caltech-fsae/IOBoard2021/IOBoard2020.pdf

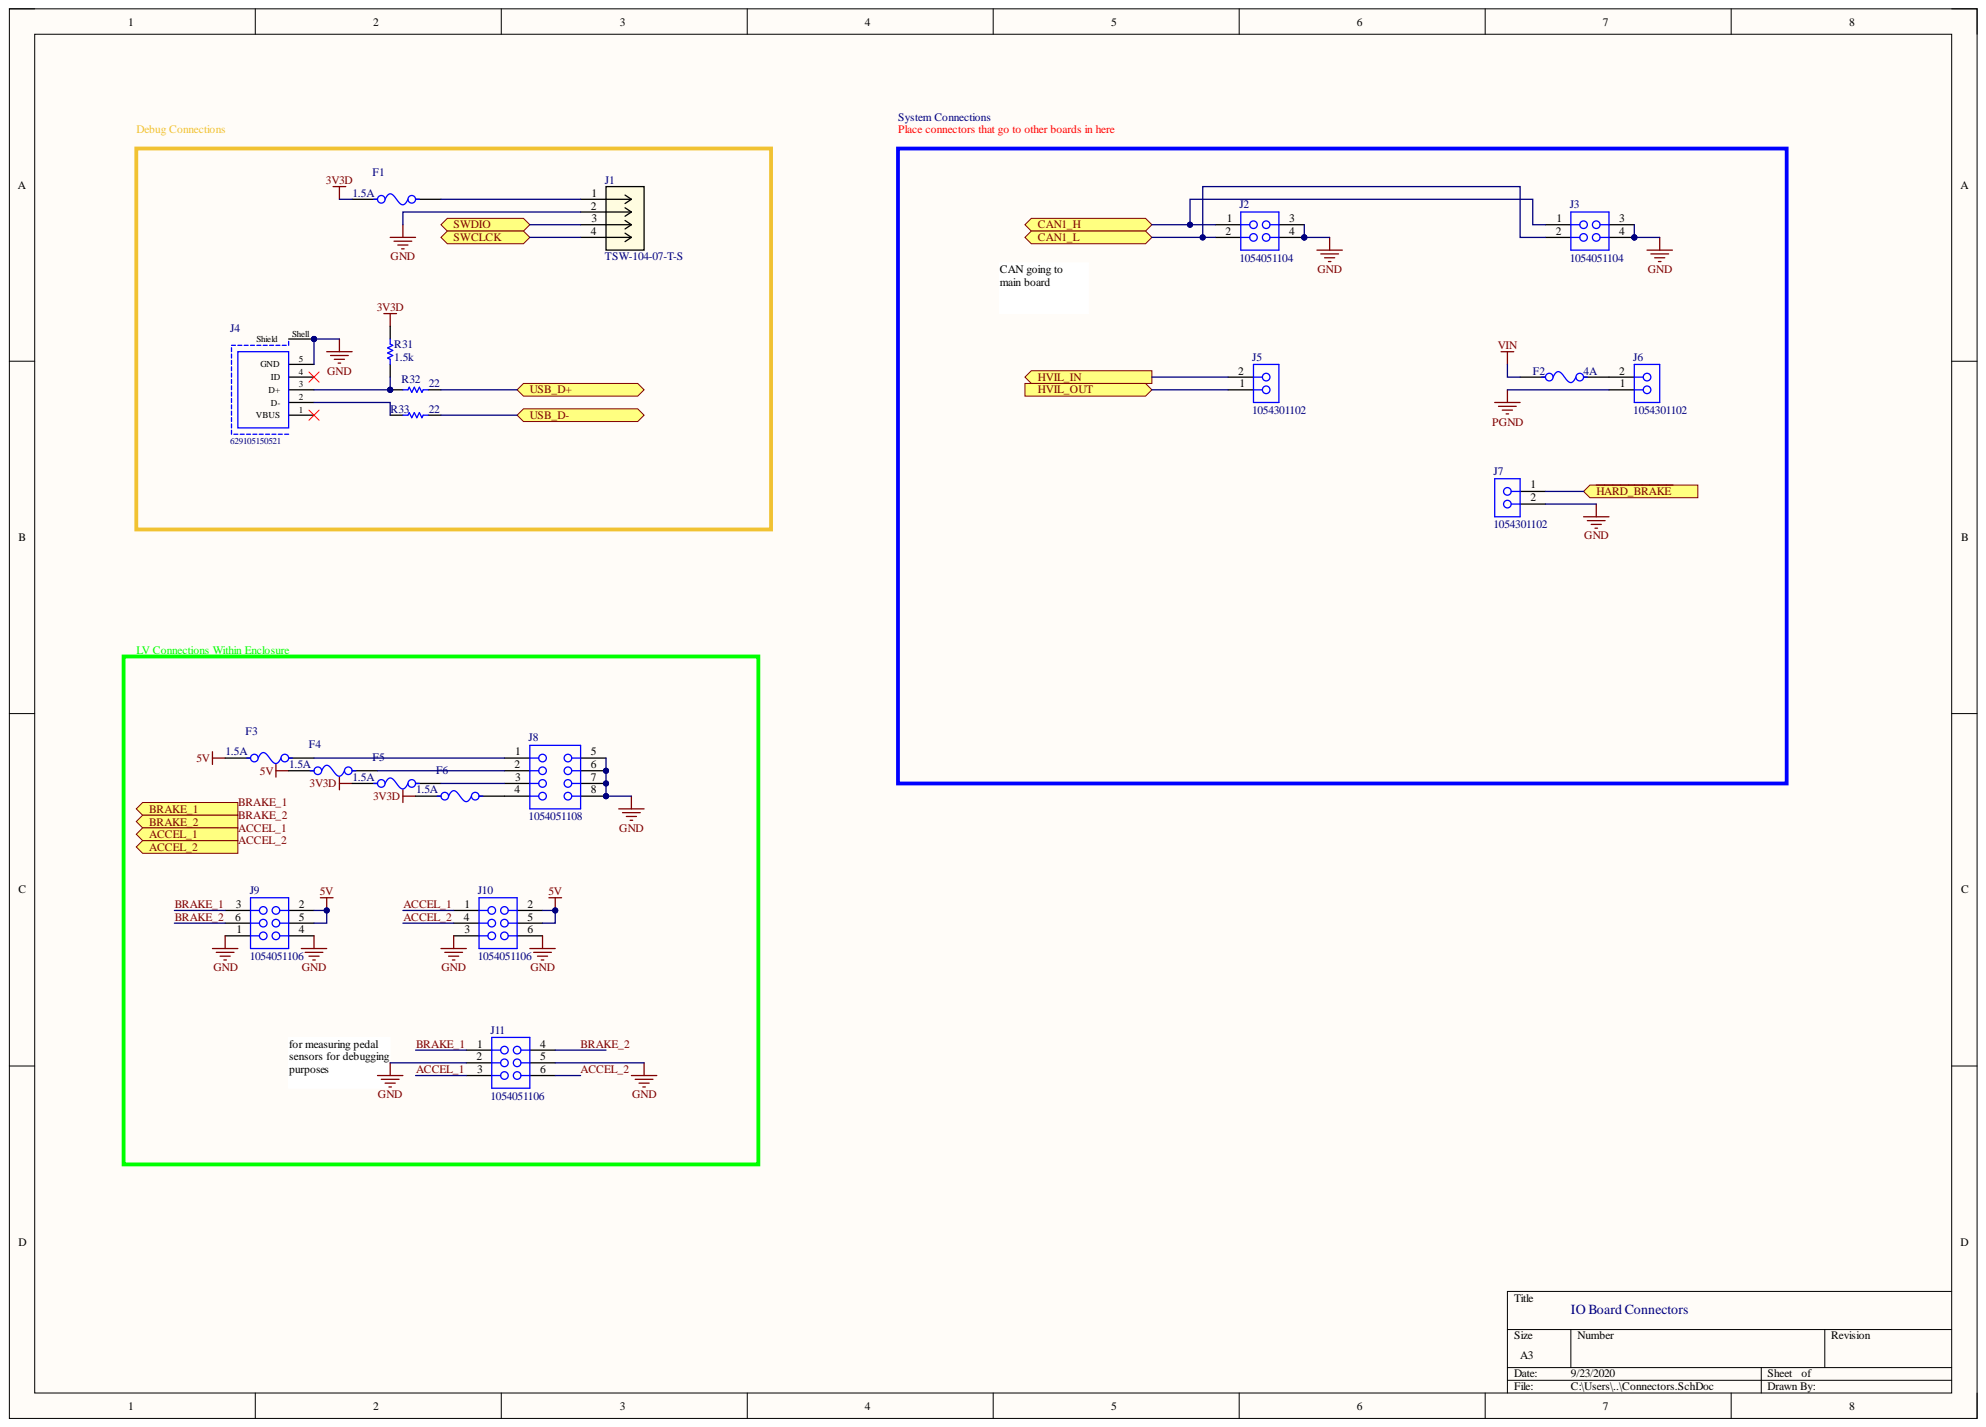
[picture p1: page 1]

J2 VIN

LV Connections Within Enclosure

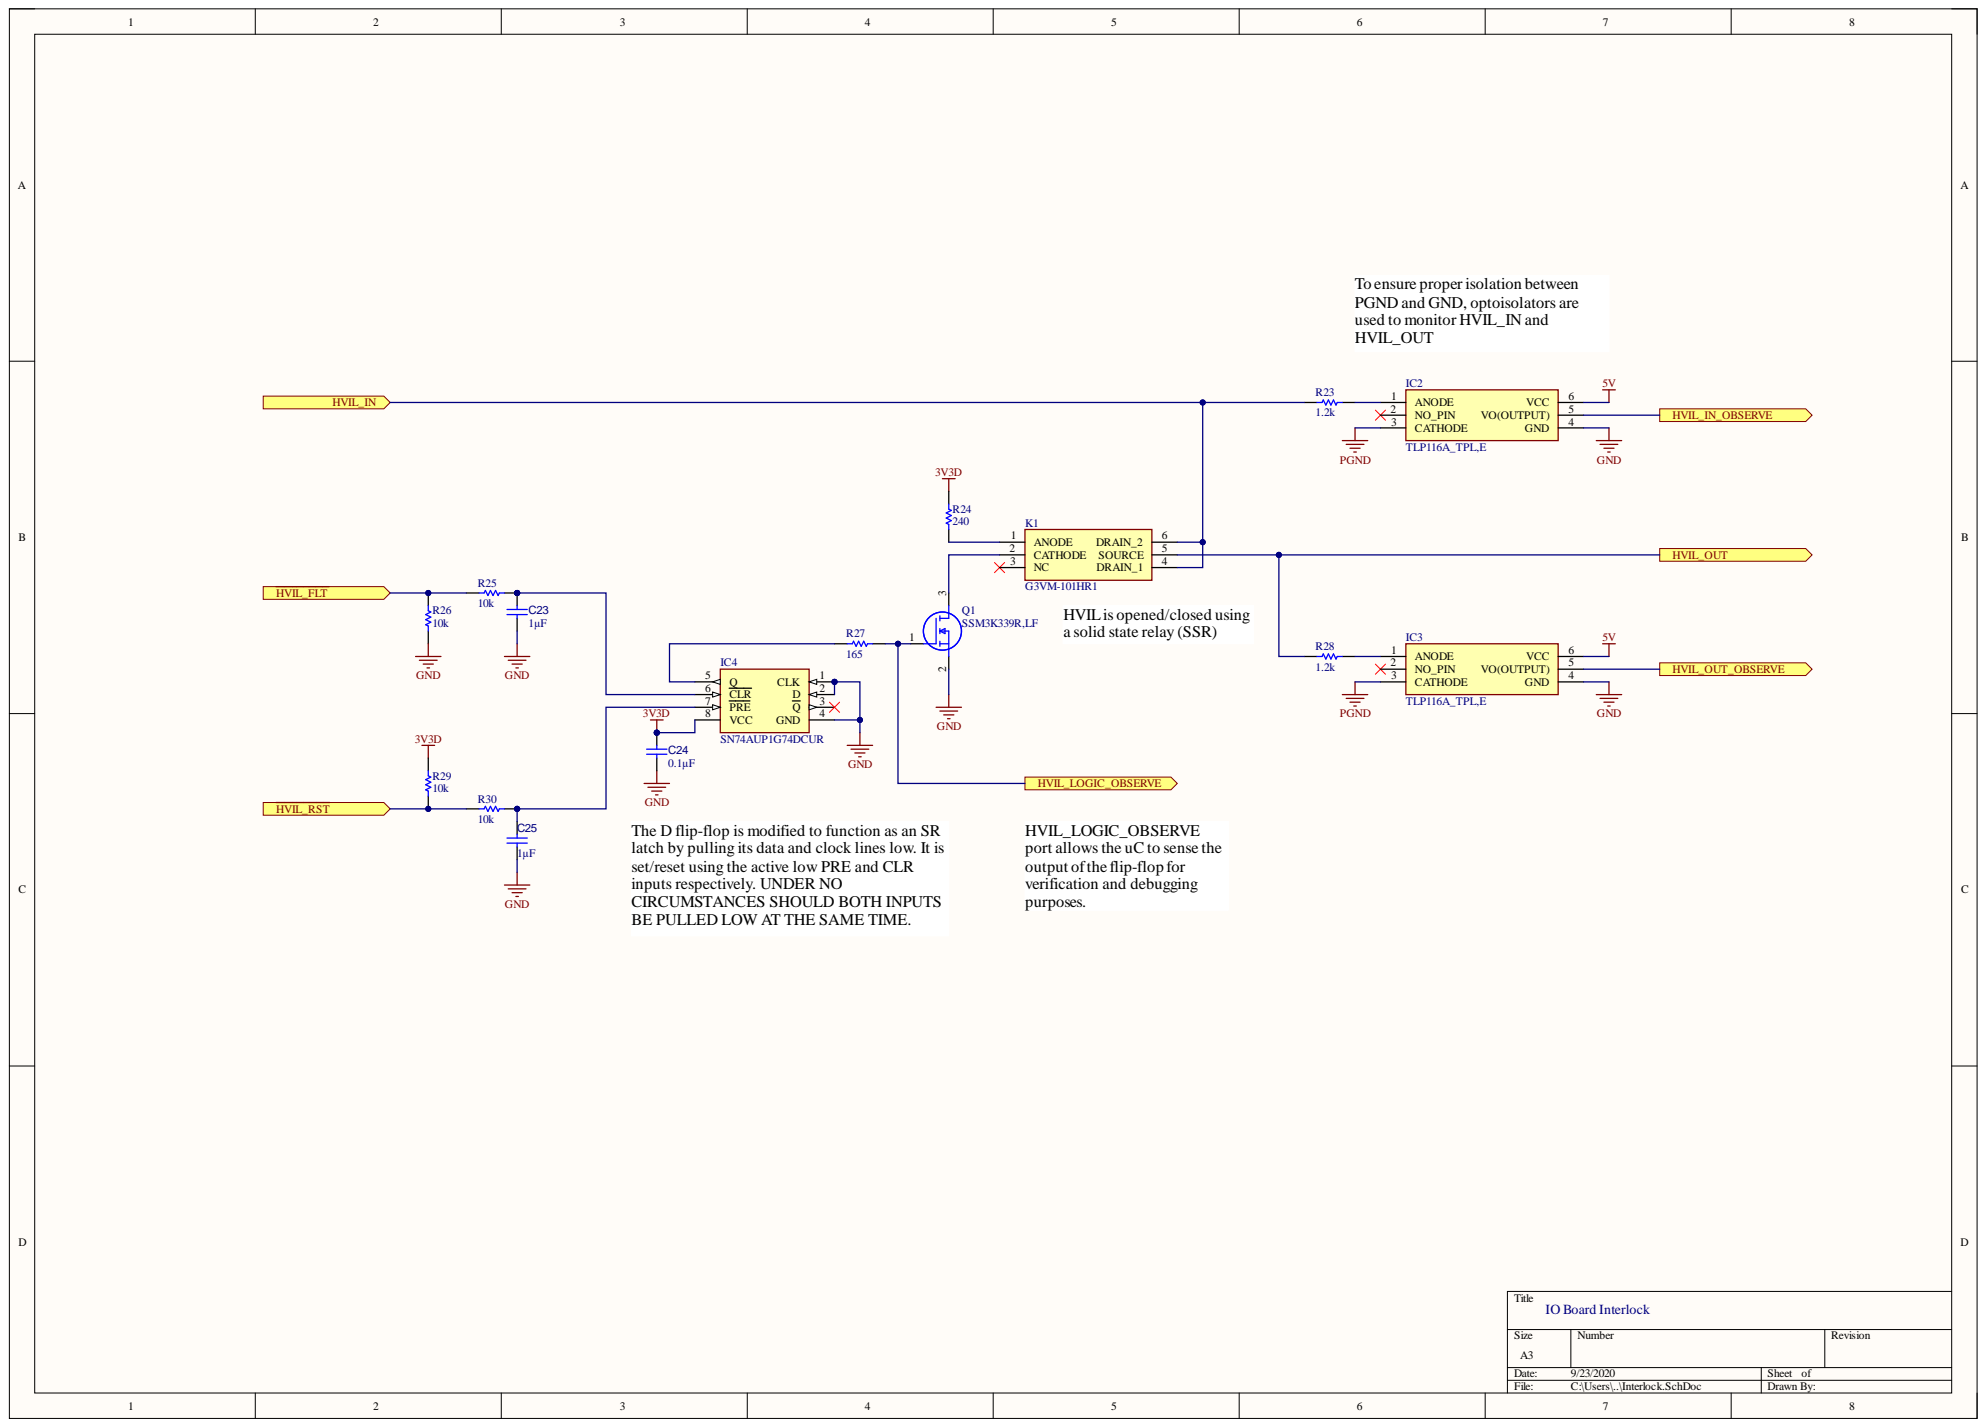
[picture p2: page 2]

To ensure proper isolation between
PGND and GND, optoisolators are
used to monitor HVIL_IN and
HVIL_OUT

HVILis opened/closed using
a solid state relay (SSR)

CLR 6 D Q | 2
PRE 7 | 3

3V3D | | VCC 8

GND
The D flip-flop is modified to function as an SR
latch by pulling its data and clock lines low. It is
set/reset using the active low PRE and CLR
inputs respectively. UNDER NO
CIRCUMSTANCES SHOULD BOTH INPUTS
BE PULLED LOW AT THE SAME TIME.

HVIL_LOGIC_OBSERVE
port allowsthe uC to sense the
output ofthe flip-flop for
verification and debugging
purposes.

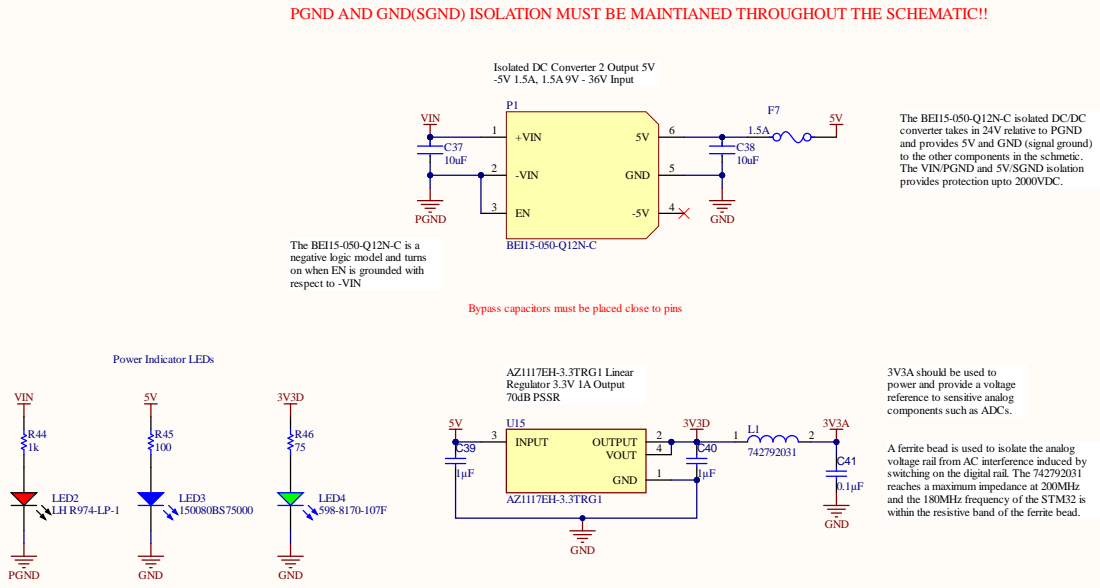
[picture p3: page 3]

PGND AND GND(SGND) ISOLATION MUST BE MAINTIANED THROUGHOUT THE SCHEMATIC!!

Isolated DC Converter 2 Output 5V
-5V 1.5A, 1.5A 9V - 36V Input

The BEI15-050-Q12N-C isolated DC/DC
converter takes in 24V relative to PGND
and provides 5V and GND (signal ground)
to the other components in the schmetic.
The VIN/PGND and 5V/SGND isolation
provides protection upto 2000VDC.

The BEI15-050-Q12N-C is a
negative logic model and turns
on when EN is grounded with
respect to -VIN

Bypass capacitors must be placed close to pins

3V3A should be used to
power and provide a voltage
reference to sensitive analog
components such as ADCs.

A ferrite bead is used to isolate the analog
voltage rail from AC interference induced by
switching on the digital rail. The 742792031
reaches a maximum impedance at 200MHz
and the 180MHz frequency of the STM32 is
within the resistive band of the ferrite bead.

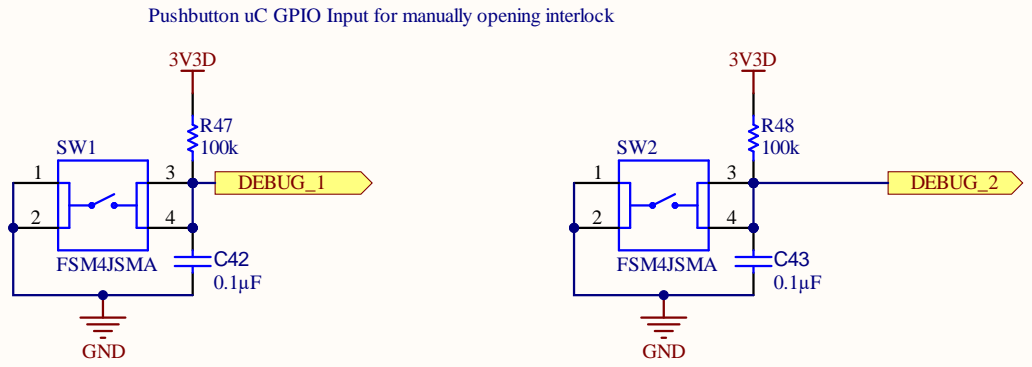
[picture p4: page 4]

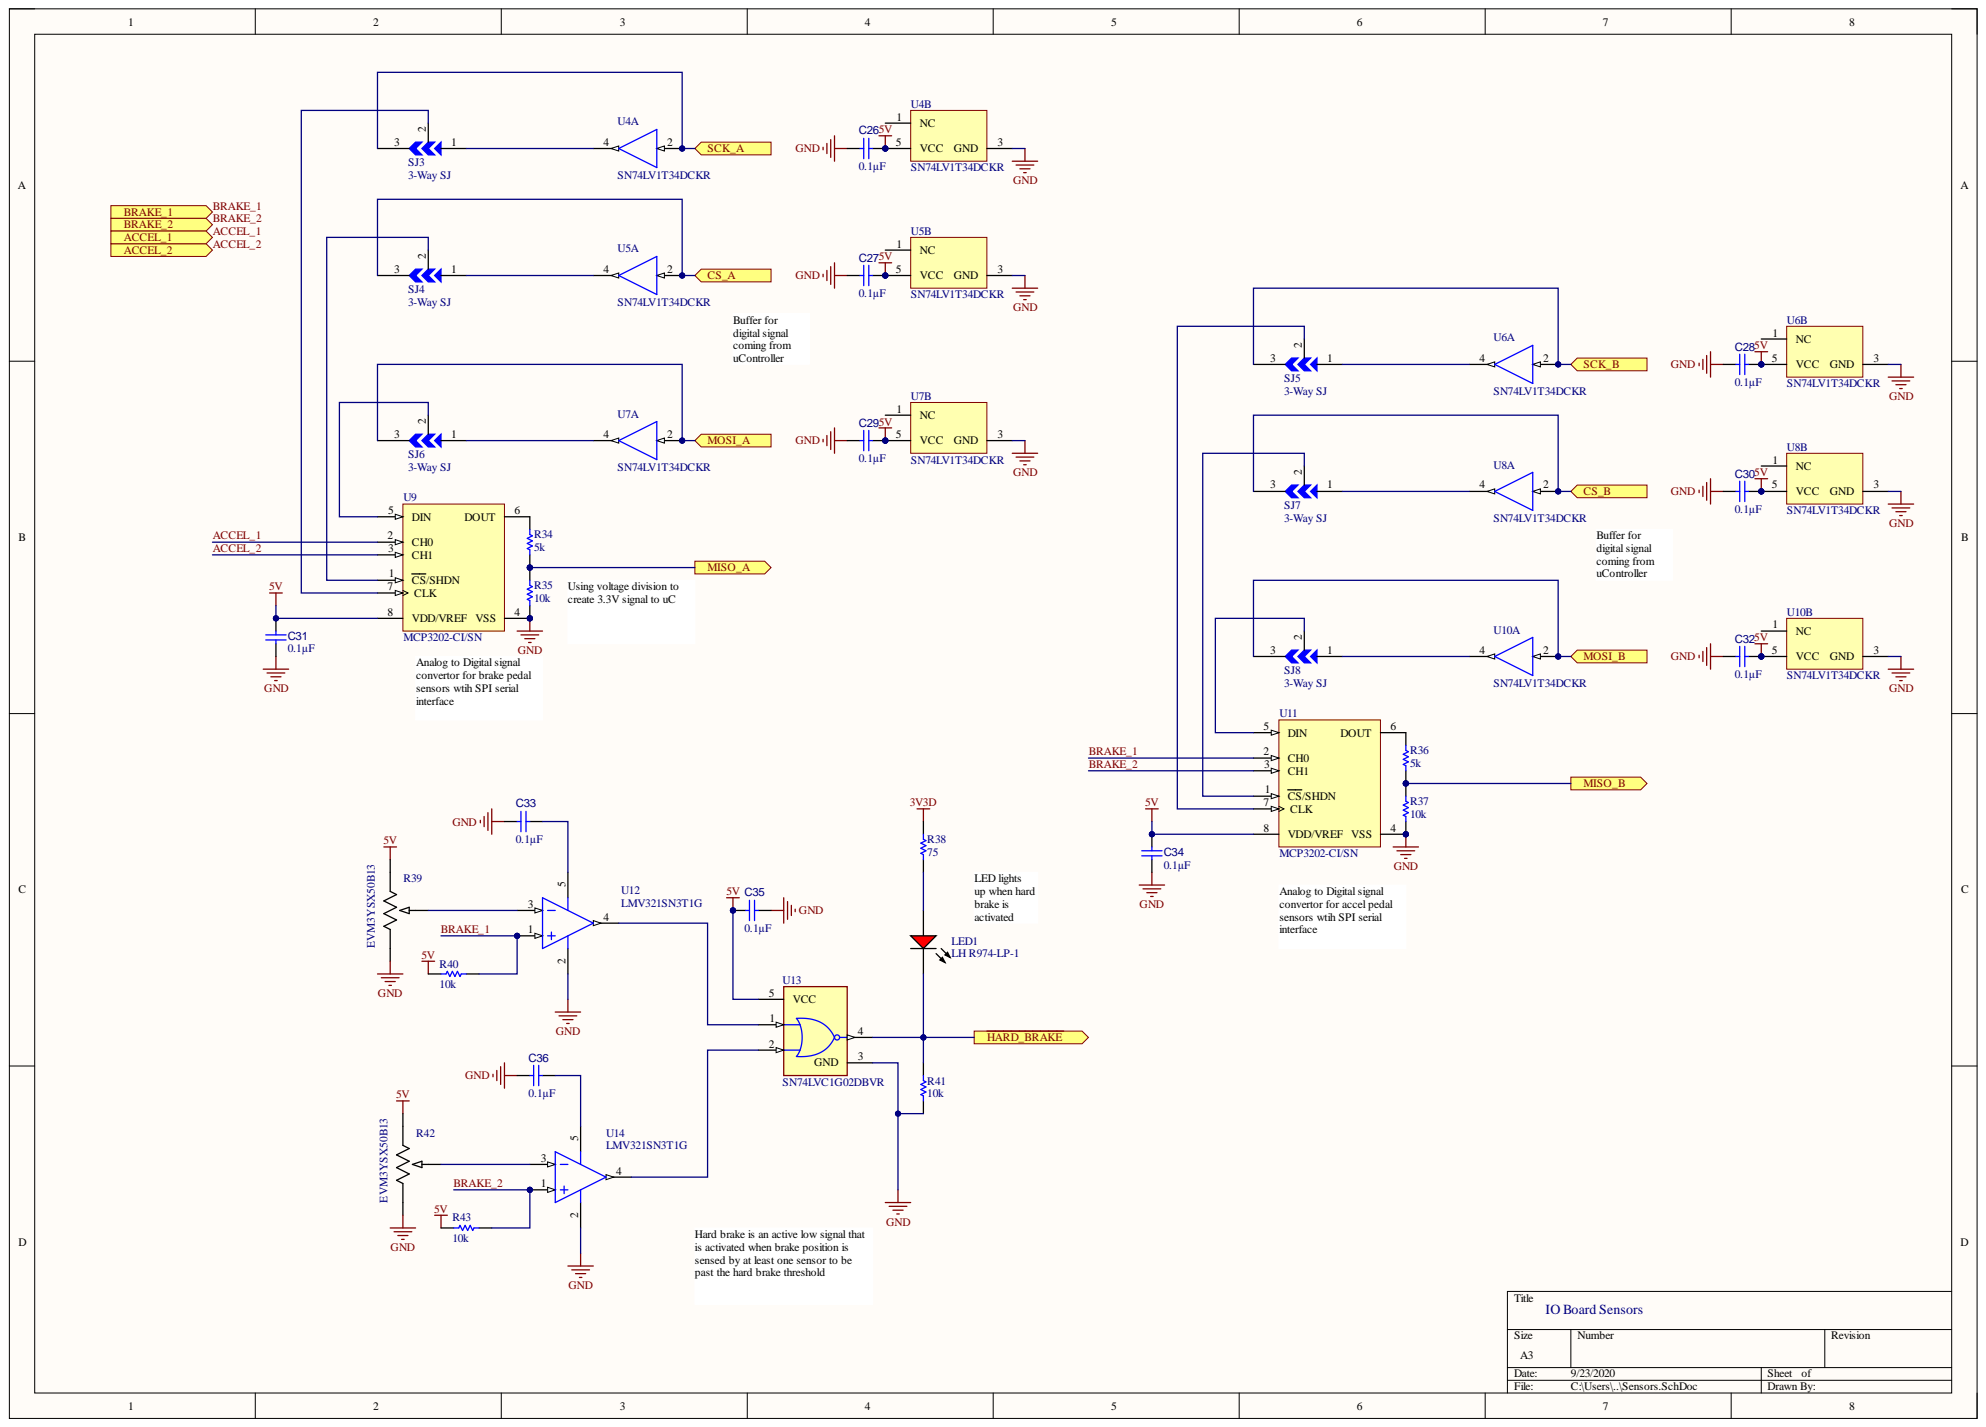
[picture p5: page 5]

Using voltage division to
create 3.3V signal to uC

Analog to Digital signal
convertor for brake pedal
sensors wtih SPI serial
interface

convertor for accel pedal

Hard brake is an active low signal that
is activated when brake position is
sensed by at least one sensor to be
past the hard brake threshold

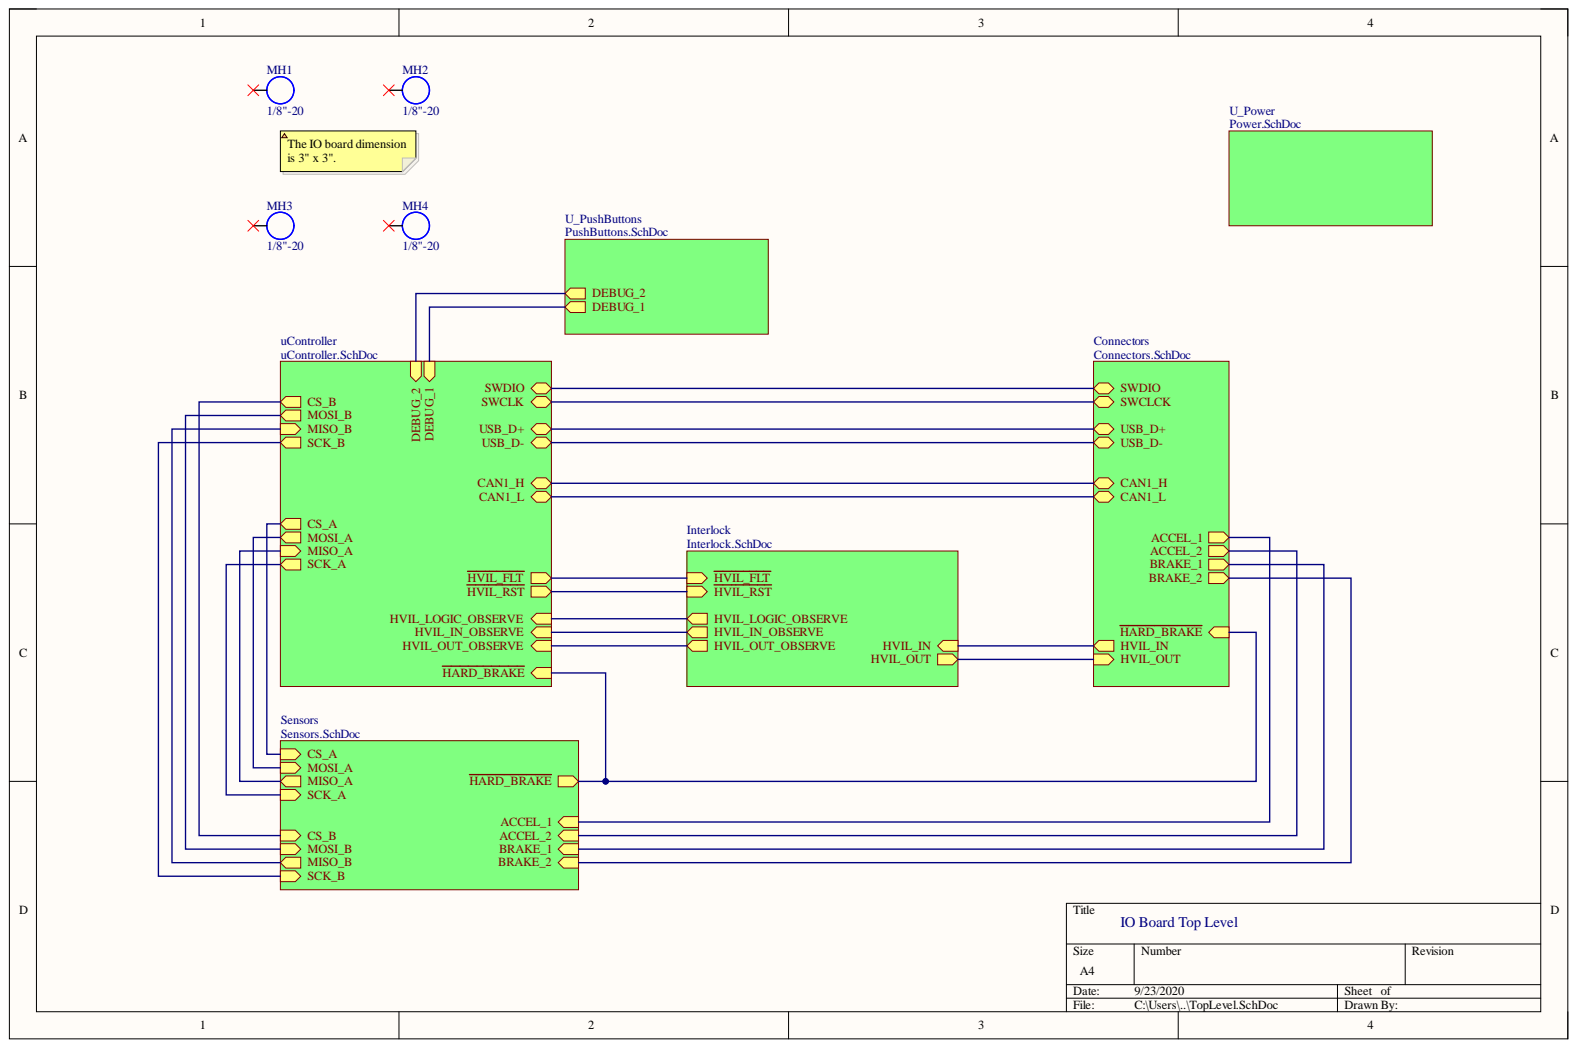
[picture p6: page 6]

The IO board dimension

Interlock.SchDoc | ACCEL_2

BRAKE_1

HVIL_FLT | BRAKE_2
HVIL_RST HVIL_LOGIC_OBSERVE HVIL_IN_OBSERVE | | HARD_BRAKE

HVIL_OUT_OBSERVE HVIL_IN HVIL_OUT | | HVIL_IN HVIL_OUT

IO Board Top Level

Size A4 | Number | Revision

Date: 9/23/2020 | Sheet of
File: C:\Users\..\TopLevel.SchDoc | Drawn By:

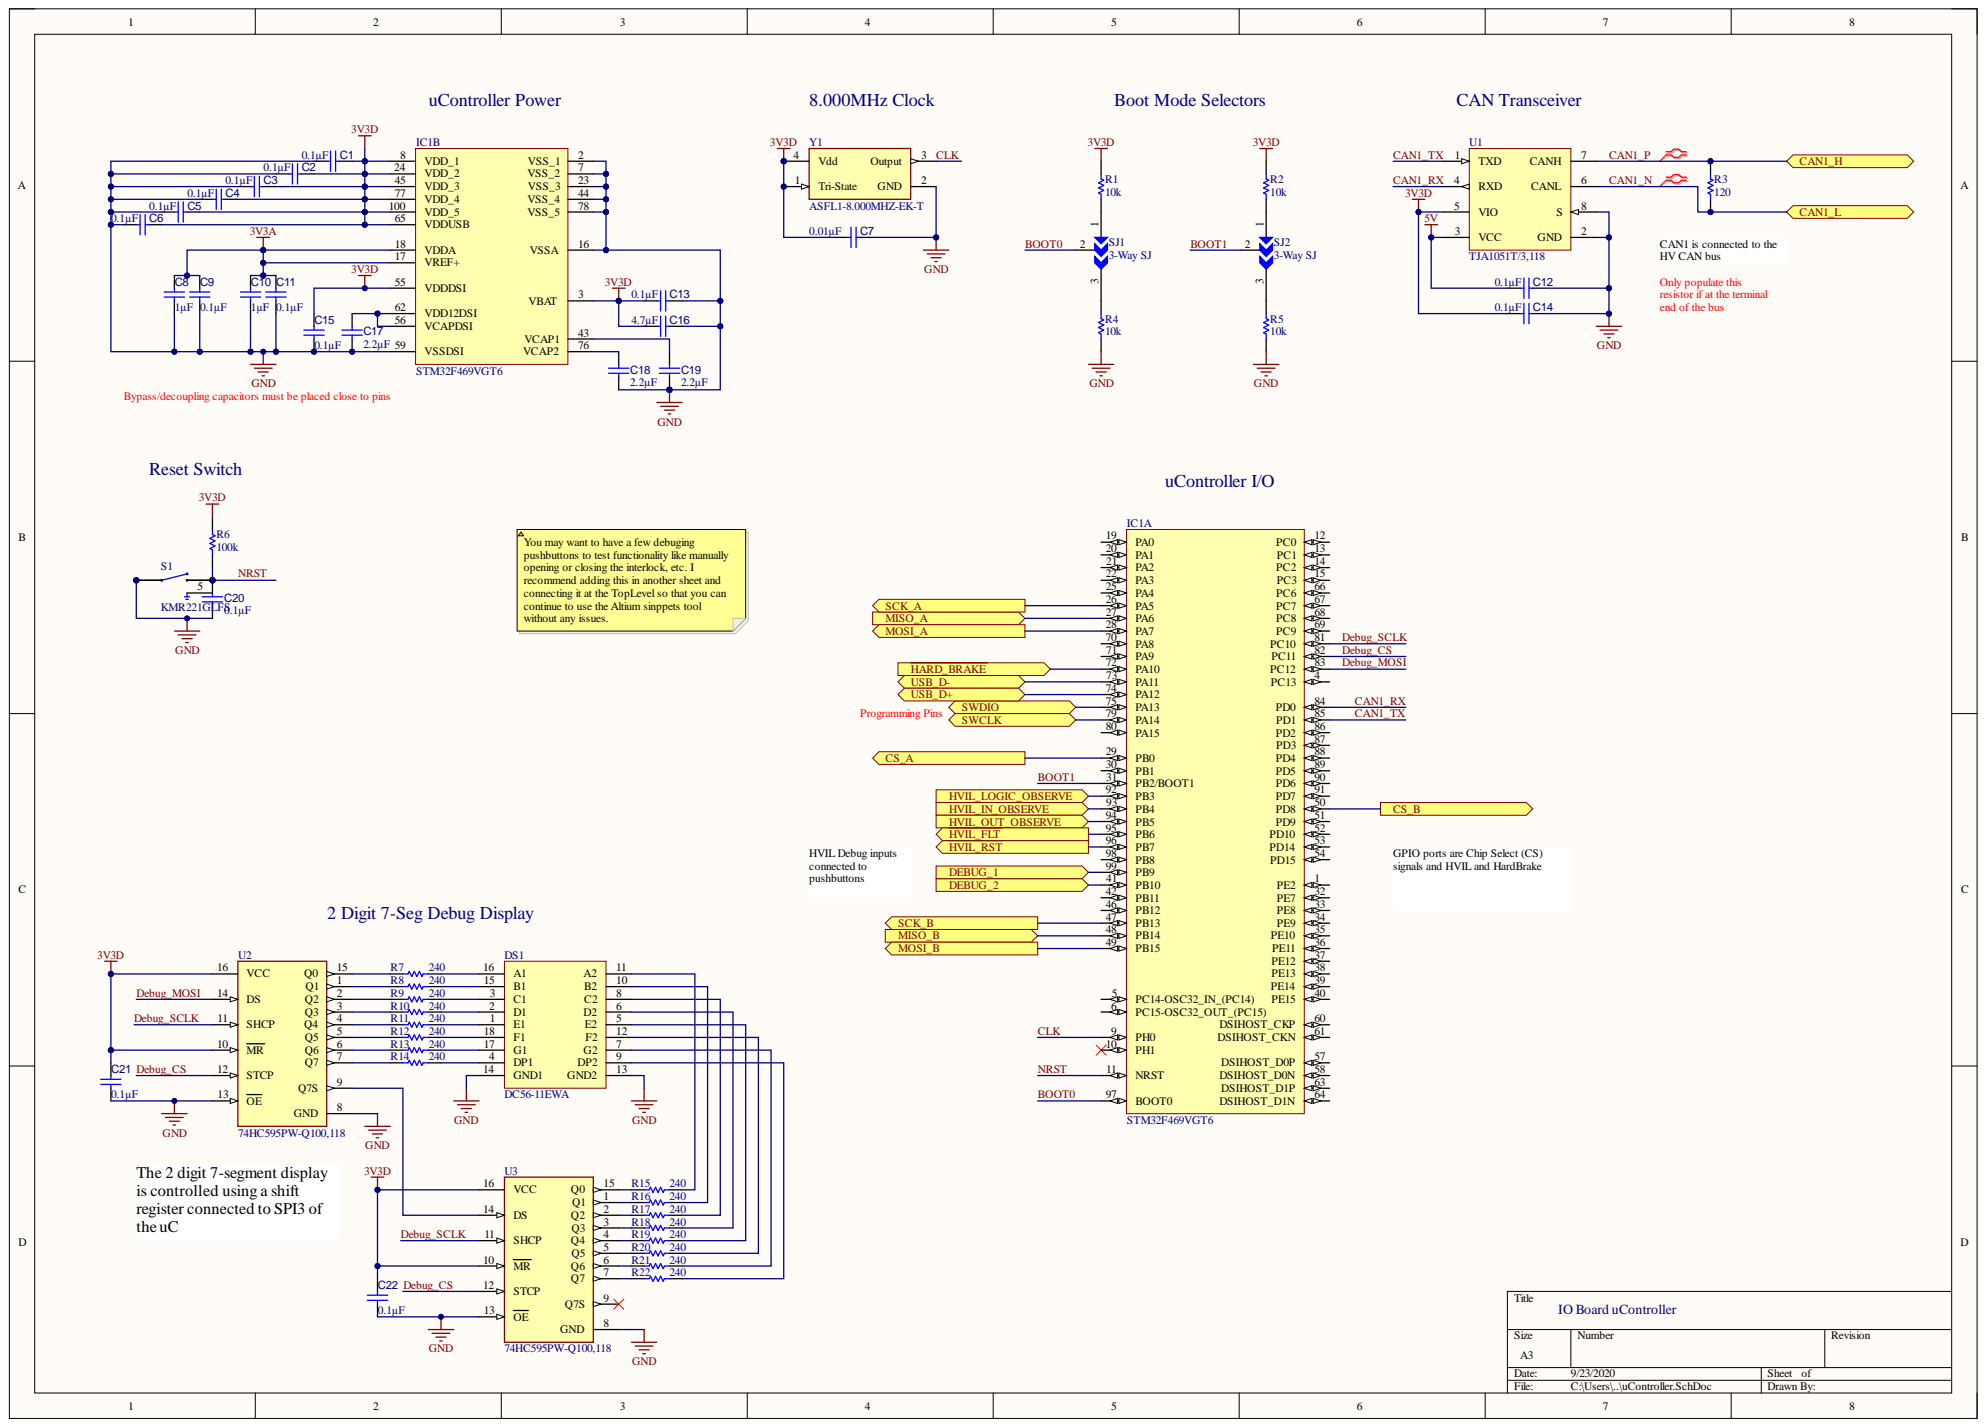
[picture p7: page 7]

CAN1 is connected to the
HV CAN bus

3V3D | | VDDDSI 55

Only populate this
resistor if at the terminal
end of the bus

C15 | VCAPDSI 56

VDD12DSI 62

Bypass/decoupling capacitors must be placed close to pins

You may want to have a few debuging
pushbuttons to test functionality like manually
opening or closing the interlock, etc. I
recommend adding this in another sheet and
connecting it at the TopLevel so that you can
continue to use the Altium sinppets tool
without any issues.

GPIO ports are Chip Select (CS)
signals and HVIL and HardBrake

2 Digit 7-Seg Debug Display

The 2 digit 7-segment display
is controlled using a shift
register connected to SPI3 of
the uC
