caltech-fsae/IOBoard2021/(list of files, drawings)

Other design files:
Connectors.SchDoc
Interlock.SchDoc
IOBoard2020.PrjPcb
PartsTemplate.SchDoc
Power.SchDoc
PushButtons.SchDoc
Sensors.SchDoc
TopLevel.SchDoc
uController.SchDoc
uControllerTemplate2021.PcbLib
uControllerTemplate2021.SchLib
